CowboyTim/halloween-barrel/(commit log)

2026-10-27 Add ESP-NOW vibrator sketch and wiring notes
    Arduino sketch for an ESP-01 ESP-NOW receiver that switches a vibrator through a MOSFET on the battery module's B- line, plus the wiring, power, and flashing notes.
    [vibrator.ino]
2026-10-27 Add barrel.py flasher and boards.toml for the ESP-01 vibrator
    Rename the fog flasher to barrel.py and adapt it for ESP-01 boards on USB-serial adapters: esp8266 core and esptool, ports set per board in boards.toml (adapters do not report a MAC), a single VIBRATOR role building vibrator/, and a single flash image at 0x0. Also update the README flashing steps and ignore dist/ and .build/.
    [barrel.py]
2026-10-27 Rename barrel.py to deploy.py and add ESP32-C3/S3 support
    deploy.py now picks the core, esptool, flash layout, flags and sketch per chip from boards.toml, so ESP-01 and ESP32-C3/S3 boards can share a role and be deployed together. update installs both cores. Adds vibrator_esp32/, the same ESP-NOW receiver for ESP32 boards (gate on GPIO4), and an esp32s3 example in boards.toml. Flashing and monitoring are not yet tested on hardware.
    [deploy.py, vibrator_esp32.ino]
2026-10-27 Button-driven vibrate with on/off lease, and the ESP32-S3 trigger
    The button now decides the timing: a press gives a 1 s burst, a double tap held gives a continuous vibrate until release. It sends on every 100 ms while the vibrators should run, and off at the end. The ESP-01 and ESP32 receivers follow on/off messages and stop when no on arrives for 500 ms, so a dead button, a lost connection or a power cut stops them. The message changes to a vibrate byte in place of a duration. Adds trigger_esp32/ (button on GPIO8, LED on GPIO7), the TRIGGER role in deploy.py, the button entry in boards.toml, a serial mac? query on all sketches (deploy.py finds boards by MAC without a reset), a debug print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
    [deploy.py, trigger_esp32.ino, vibrator.ino, vibrator_esp32.ino]
2026-10-27 Add wiring schematic and switch the vibrator with the MOSFET module
    docs/schematic.svg shows the power and switching design: the TinyTronics MOSFET module (5-36 V, 15 A) switches the boost's 5 V output to the vibrator, replacing the discrete MOSFET, gate resistor and pulldown. The ESP-01 stays on the battery through the LDO. The README wiring, parts and notes follow the same design, and link the schematic. Fuse and flyback diode are kept; the diode is only needed if the module has none. The module's D4184 marking is not confirmed.
2026-10-27 Log and serial-control the button, add the test suite, and the ESP-01 pinout
    Both boards log every event with a time in ms and a sequence number. The button takes press, mute and status commands over its serial port. An off is sent three times, since broadcasts are not acknowledged. The vibrator reports the reason for each stop, command or lease. Adds tests/test_button.py, seven tests over the USB ports that cover bursts, double-tap hold, the lease, latency and matching logs. The serial reads no longer block, and deploy.py opens ports with DTR and RTS low so opening does not reset the boards. Adds the ESP-01 pinout image.
    [deploy.py, trigger_esp32.ino, vibrator.ino, vibrator_esp32.ino]
2026-10-27 Add the programmer and LED test diagrams
    docs/programmer.svg shows the CH340E module wired to an ESP-01 breadboard module: 3V3 and GND, TXD and RXD crossed, DTR to RST through 10 k, the GPIO0 button, and a bulk capacitor at the ESP-01 supply. docs/led-test.svg shows the MOSFET module switching an LED, as a bench check before the vibrator. The README lists both diagrams and the pinout image.
2026-10-27 Add the ESP-01 relay on GPIO0 and its boards.toml entry
    relay/relay.ino switches a relay on GPIO0 with the same ESP-NOW on/off messages and lease as the vibrator, logging each change with its sequence number. GPIO0 is driven only after boot, so the relay is off during reset. deploy.py gets a RELAY role, and boards.toml has the relay board's MAC. The README notes the boot-pin constraint and the ACTIVE_LOW setting.
    [deploy.py, relay.ino]
2026-10-27 Drive the MOSFET module from GPIO2 through 100 ohm, no pulldown
    The schematic and README now show the working design: GPIO2 through 100 ohm to the MOSFET module's Trig input, with no pulldown. The NPN inverter and its resistors are removed from the drawing. The vibrator firmware drives GPIO2 HIGH to vibrate, as before.
2026-10-27 Use the HT4928S charger and boost in the schematic and README
    The power section now shows the HT4928S: micro-USB in for charging, BTP to the battery, and its 5.1 V USB-A output, cut open, feeding the MOSFET module. The README notes the HT4928S standby limit (about 60 mA for 8 s), so the vibrator must draw more than that while it runs. The datasheet is added as docs/HT4928S.PDF.
